rafaelmartins/db-synth/README.md

# db-synth

A MIDI-controlled mono-voice digital synthesizer built on top of the AVR DB microcontroller series.

For documentation, please visit: https://rafaelmartins.com/p/db-synth/

PCB 3D Rendering - Front
