rafaelmartins/db-synth/3d-models/enclosure-back.stl

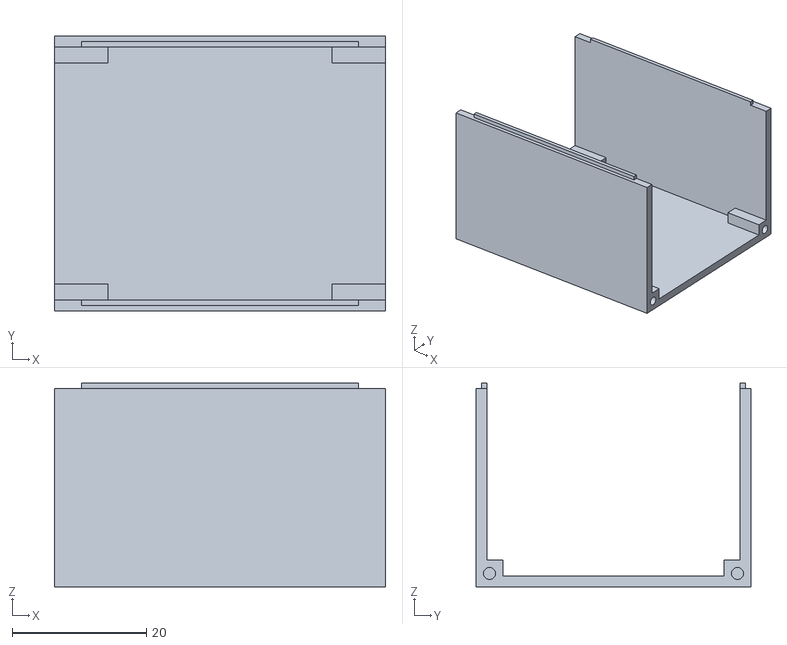
[picture p3: CAD file, 2023-04-09]
3d-models/enclosure-back.stl
49.3 x 41.0 x 30.4
