rafaelmartins/db-synth/3d-models/enclosure-front.stl

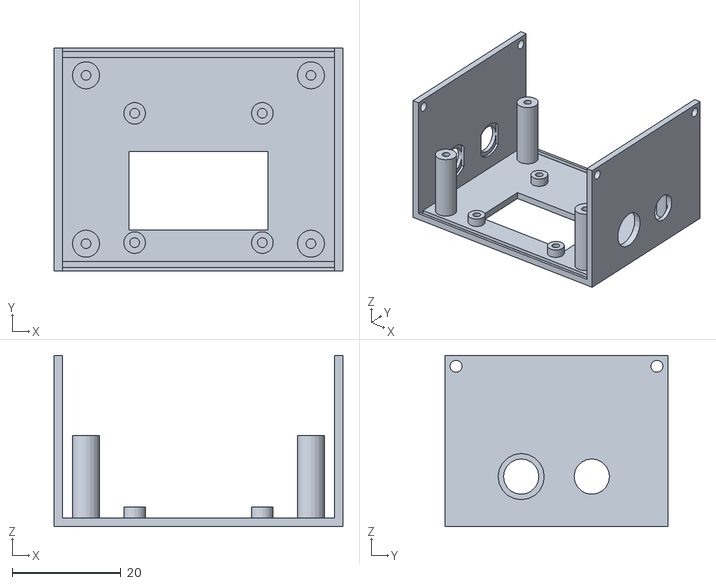
[picture p4: CAD file, 2023-04-09]
3d-models/enclosure-front.stl
53.2 x 41.0 x 31.5
