rafaelmartins/db-synth/(commit log)

2022-07-17 pcb: first revision: 1.0
    [db-synth.kicad_pcb, db-synth.kicad_sch]
2022-07-17 3d-models: initial enclosure base
    [enclosure.scad, enclosure.stl]
2022-07-17 pcb: fix revision and title
    [db-synth.kicad_pcb]
2022-07-18 firmware: initial implementation
    missing oled screens, midi cc, etc.
    [adsr.c, adsr.h, main.c, midi.c, midi.h, oled.c]
2022-07-18 firmware: oled: optimizations
    share work load between task calls, pre-render fonts, avoid memsets,
    etc.
    [oled-font.h, oled.c]
2022-07-20 firmware: increase DAC VREF to 2.5v. minor fixes
    [adsr.c, main.c]
2022-07-24 pcb: new revision: 1.1
    reduced part usage: no LDO and USART pull up resistor needed.
    use default TWI pins, that are closer to connector, as MVIO is not
    needed anymore.
    [db-synth.kicad_pcb, db-synth.kicad_sch]
2022-07-24 firmware: adapt to hardware revision 1.1
    - enable internal pull-up resistor for MIDI RX USART pin
    - use main I2C pins for oled
    - disable MVIO in fuses
2022-07-24 3d-models: adapt to hardware revision 1.1
    [enclosure.scad, enclosure.stl]
2022-07-24 firmware: fix fuxes. enable BOD, preserve EEPROM when erasing chip
    [main.c]
2022-07-29 firmware: convert oscillator library to header-only
    [main.c, oscillator.c, oscillator.h]
2022-08-05 firmware: oled: rewrite tasks, error handling, etc.
    [main.c, oled.h]
2022-08-05 firmware: oled: fix invalid array access, remove unused functions
    [oled.h]
2022-08-06 firmware: adsr: oscillator: minor improvements
    [adsr.h, oscillator.h]
2022-08-08 Revert "firmware: re-split source and headers"
    splitted code looks pretty, but degrades performance too much :(
    This reverts commit 37d53f25af8e4bb12ddd83ce2f049714c84df048.
    [adsr.c, adsr.h, main.c, midi.c, midi.h, oled.c, oled.h, oscillator.c]
2022-08-08 firmware: filter: initial implementation of 1-pole filters
2022-08-09 firmware: use flag polling instead of interrupt service routines.
    this also removes the `volatile` qualifiers, which are not needed since
    there are no interrupts, and the compiler knows when variables need to be
    reloaded.
2022-08-09 firmware: filter: save one r16-r23 register.
    sometimes the build would fail because there was no register in the
    r16-r23 range. this happens because the compiler may use these registers
    for its own internal work. save one register by spending one extra cycle.
    [filter.h]
2022-08-15 firmware: split velocity handling out of adsr
2022-08-22 3d-models: rewrite enclosure model. add back model.
    [enclosure-back.scad, enclosure-back.stl, enclosure-front.scad, enclosure-front.stl, enclosure.scad, enclosure.stl, settings.scad]
2022-08-24 3d-models: improvements. hopefully this is the final enclosure.
    [enclosure-back.scad, enclosure-back.stl, enclosure-front.scad, enclosure-front.stl, settings.scad]
2022-09-17 firmware: midi: support midi output
    next pcb revision will add a midi output, this patch adds support for
    it, as a very simple midi-thru for now. this should not cause any issues
    with current pcb revision (1.1)
    [midi.h]
2022-09-18 pcb: new revision: 1.2
    this revision adds a MIDI output, to allow daisy-chaining units to produce
    richer sounds. it should work like a MIDI-thru, but I may want to not pass
    messages processed by the current unit thru.
    [db-synth.kicad_pcb, db-synth.kicad_sch]
2022-09-18 3d-models: adapt to pcb revision 1.2
    [enclosure-front.scad, enclosure-front.stl, settings.scad]
2022-09-26 3d-models: rebuild enclosure-back.stl
    [enclosure-back.stl]
2022-10-03 README: interactive bom link is already valid
2022-10-05 build: add gerber to archive, use zip instead of tar.xz
2022-12-08 firmware: filter: redesign progmem layout and optimize lpm calls
    [filter.c]
2022-12-08 firmware: filter: remove useless attribute
2023-01-07 pcb: new revision: 1.3
    this revision adds a 3rd pin to UPDI programming connector, to allow usage of
    official Microchip probes, like PICKit 4, Atmel-ICE, etc.
    [db-synth.kicad_pcb, db-synth.kicad_sch]
2023-02-21 pcb: remove duplicated pin from AVR128DB28 symbol
    as this does not changes the PCB file significantly, and the gerbers are
    tested, they were not re-generated and version was not bumped.
    [db-synth.kicad_pcb, db-synth.kicad_sch]
2023-03-06 build: ibom: use light theme, exclude mounting holes
2023-04-09 3d-models: adapt to pcb revision 1.3
    [enclosure-back.stl, enclosure-front.stl, settings.scad]
2023-04-21 firmware: use synth-datagen instead of generate.py
    results are slightly different and include fixes for some problems I
    found while developing synth-datagen.
    [adsr.c, filter.c, main.c]
2023-04-21 firmware: oscillator: replace division with lookup
    [oscillator.c, synth-datagen.yml]
2023-04-25 firmware: oled: avoid divisions
    [oled.c, oled.h]
2023-04-25 firmware: oled: avoid memset
    [oled.c]
2023-04-25 firmware: adsr: fix comments
    [adsr.c]
2023-04-27 firmware: oscillator: rework phase step
    [oscillator.c, oscillator.h]
2023-05-24 firmware: avoid PROGMEM and strcpy calls
    I just realized that SRAM fits all our static data, except wavetables,
    resulting on a reasonable speedup.
    [adsr.c, filter.c, main.c, oled-font.h, oled.c]
2023-06-10 firmware: filter: remove, broken design.
    [filter.c, filter.h, main.c, screen.c, screen.h, settings.c]
2024-01-09 pcb: upgrade to kicad 7
    [db-synth.kicad_pcb, db-synth.kicad_sch]
2024-01-09 pcb: upgrade symbols and footprints (do not fully pass drc)
    [db-synth.kicad_pcb, db-synth.kicad_sch]
2024-01-09 build-aux: use kicad 7
2024-01-09 pcb: update custom libraries
    [db-synth.kicad_pcb]
2024-01-11 pcb: new revision: 20240111
    this revision adds a connector for a reset button, two test points for
    development, allows usage of better capacitors, replaces our custom AVR
    symbol with a new one from kicad 7 and adds new 3d models.
    [db-synth.kicad_pcb, db-synth.kicad_sch]
2025-02-10 pcb: upgrade to kicad 8
    [db-synth.kicad_pcb, db-synth.kicad_sch]
2025-11-05 pcb: upgrade to kicad 9
    [db-synth.kicad_pcb, db-synth.kicad_sch]
2026-02-23 Revert "firmware: filter: remove, broken design."
    This reverts commit 1aa5f97f8dc937641b321b29baea13f0a3f01b19.
    [filter.c, filter.h, main.c, screen.c, screen.h, settings.c]
2026-02-23 firmware: fix synth-datagen settings and regenerate
    [filter.c]
2026-02-23 filter: fix algorithm and limit output range
    [filter.c, filter.h, main.c]
2026-02-23 firmware: enable reset pin in fuses
2026-02-24 build: disable website, add pcb assets pipeline
